xiaojunyang0805/SaxStat/software/saxstat_gui_v1/README.md

# SaxStat GUI v1.2 - Production Ready

Modern PyQt5-based GUI for the SaxStat portable potentiostat with comprehensive experiment support and analysis tools.

## Status
✅ **Production Ready (v1.2)** - Complete with 7 experiments, 4 analysis tools, gain selection, standalone executable

## Features

**Core Capabilities:**
- **7 Experiment Types:** CV, LSV, CA, SWV, DPV, NPV, POT - all production-ready
- **4 Analysis Tools:** Peak detection, baseline correction, integration, smoothing
- **Gain Selection:** 10⁴ V/A (±500 µA) / 10⁶ V/A (±100 nA) via GUI radio buttons
- **Real-time Plotting:** Dual plots with high-performance pyqtgraph
- **Professional Data Export:** CSV, JSON, Excel with formatted multi-sheet output
- **Autosave System:** Configurable automatic data saving with preferences dialog
- **Parameter Presets:** Save/load/delete presets per experiment type
- **Plot Overlays:** Compare up to 5 experiments with legend support
- **Hardware Calibration:** Offset current, TIA resistance, Vref configuration
- **Experiment History:** Automatic storage of last 50 runs for comparison
- **Standalone Executable:** `SaxStat.exe` via PyInstaller (no Python required)

**Architecture:**
- **Modular Design:** Clean separation with template method pattern
- **Plugin System:** Auto-registration decorator for experiments
- **Thread-safe Communication:** Background serial I/O with SerialManager
- **Type-safe Validation:** Parameter schemas with min/max constraints
- **Configuration Management:** JSON-based persistent settings with presets

## Supported Experiments (7 Total)

1. **Cyclic Voltammetry (CV):** Classic CV with multiple cycles
2. **Linear Sweep Voltammetry (LSV):** Single sweep voltage scan
3. **Chronoamperometry (CA):** Step potential vs time
4. **Square Wave Voltammetry (SWV):** High sensitivity differential measurement
5. **Differential Pulse Voltammetry (DPV):** Pulse waveform for trace analysis
6. **Normal Pulse Voltammetry (NPV):** Pulses from baseline potential
7. **Potentiometry (POT):** Open circuit potential monitoring

## Quick Start

### Requirements

```bash
pip install -r requirements.txt
```

Required packages:
- PyQt5 >= 5.15.0 (GUI framework)
- pyserial >= 3.5 (serial communication)
- numpy >= 1.21.0 (numerical processing)
- pandas >= 1.3.0 (data management)
- scipy >= 1.7.0 (analysis tools)
- pyqtgraph >= 0.12.0 (real-time plotting)
- openpyxl >= 3.0.0 (Excel export)

### Running the GUI

```bash
python run.py
```

Or from parent directory:
```bash
python -m saxstat_gui_v1.main
```

## Usage

1. **Select Experiment:** Choose from 7 experiment types in dropdown
2. **Connect Hardware:** Select serial port and click "Connect"
3. **Select Gain:** Choose 10⁴ V/A (±500 µA) or 10⁶ V/A (±100 nA)
4. **Load Preset (Optional):** Select saved parameter preset from dropdown
5. **Configure Parameters:** Adjust experiment parameters or use defaults
6. **Calibrate (Optional):** Settings → Calibration for hardware parameters
7. **Configure Experiment:** Click "Configure Experiment" to validate parameters
8. **Start Experiment:** Click "Start Experiment" to begin acquisition
9. **View Real-time Data:** Dual plots show voltage vs time and current vs voltage
10. **Analyze Data:** Analysis → Data Analysis Tools for peak detection, baseline correction, etc.
11. **Compare Runs:** View → Compare Experiments to overlay multiple runs
12. **Save Results:** Data auto-saves if enabled, or manually save with File → Save Data

**Menu Features:**
- **File:** Save Data (Ctrl+S), Save Plot, Exit (Ctrl+Q)
- **Analysis:** Data Analysis Tools (Ctrl+A)
- **View:** Compare Experiments (Ctrl+E)
- **Settings:** Preferences (Ctrl+P), Calibration
- **Help:** About

## Architecture

```
saxstat_gui_v1/
├── gui/                        # PyQt5 UI components
│   ├── main_window.py          # Main application window (980 lines)
│   ├── parameter_panel.py      # Dynamic parameter panel with presets (361 lines)
│   ├── analysis_panel.py       # Data analysis tools UI (267 lines)
│   ├── preferences_dialog.py   # Autosave preferences (203 lines)
│   ├── overlay_dialog.py       # Experiment comparison (165 lines)
│   └── calibration_dialog.py   # Hardware calibration (236 lines)
├── experiments/                # Experiment implementations (7 total)
│   ├── base_experiment.py      # Abstract base class (268 lines)
│   ├── experiment_registry.py  # Registry pattern (116 lines)
│   ├── cyclic_voltammetry.py   # CV implementation (277 lines)
│   ├── linear_sweep.py         # LSV implementation (280 lines)
│   ├── chronoamperometry.py    # CA implementation (285 lines)
│   ├── square_wave.py          # SWV implementation (357 lines)
│   ├── differential_pulse.py   # DPV implementation (389 lines)
│   ├── normal_pulse.py         # NPV implementation (397 lines)
│   └── potentiometry.py        # POT implementation (267 lines)
├── analysis/                   # Data analysis tools (4 total)
│   ├── peak_detection.py       # Peak finding (196 lines)
│   ├── baseline_correction.py  # Baseline subtraction (197 lines)
│   ├── integration.py          # Charge calculation (173 lines)
│   └── smoothing.py            # Filtering (186 lines)
├── communication/              # Hardware communication
│   └── serial_manager.py       # Thread-safe serial I/O (220 lines)
├── data/                       # Data management
│   └── data_manager.py         # Collection, export, history (300 lines)
├── plotting/                   # Plotting functionality
│   └── plot_manager.py         # Real-time plotting with overlays (316 lines)
├── config/                     # Configuration management
│   └── config_manager.py       # JSON settings with presets (282 lines)
└── main.py                     # Application entry point
```

## Hardware Protocol

Compatible with prototype_v03 firmware:

**Commands:**
- `START:<start_v>:<end_v>:<scan_rate>:<cycles>` - Start CV experiment
- `STOP` - Stop current experiment
- `CALIBRATE` - Run calibration routine
- `MODE_0` / `MODE_1` - Switch gain (10kΩ / 1MΩ TIA)

**Data Format:**
- ADC values: 0-32767 (ADS1115 16-bit)
- Completion message: "CV complete."

**Hardware Specs:**
- Voltage range: -1.5V to +1.5V
- DAC: AD5761 (16-bit)
- ADC: ADS1115 (16-bit)
- TIA: 10kΩ (MODE_0) or 1MΩ (MODE_1)
- Gain switches: TS5A3160 on GPIO 33/25
- Reference: 1.0V

## Configuration

Configuration stored in `~/.saxstat/config.json`:

- Serial port settings (baudrate, timeout, last port)
- UI preferences (window size, theme)
- Experiment defaults (autosave, save directory)
- Calibration values (offset current, TIA resistance, Vref)
- Gain selection (mode 0 or 1)

## Adding New Experiments

1. Create new file in `experiments/` directory
2. Inherit from `BaseExperiment`
3. Implement required methods:
   - `get_name()` - Return experiment name
   - `get_parameters()` - Define parameter schema
   - `validate_parameters()` - Validate parameter values
   - `generate_command()` - Create firmware command
   - `process_data_point()` - Parse and process data
   - `get_plot_config()` - Configure plot axes
4. Add `@register_experiment` decorator
5. Import in `experiments/__init__.py`

See `cyclic_voltammetry.py` for complete example.

## Development Status

**v1.2 - Production Ready** - ✅ Complete

**Completed Features:**
- ✅ 7 experiment types (CV, LSV, CA, SWV, DPV, NPV, POT)
- ✅ 4 data analysis tools (peaks, baseline, integration, smoothing)
- ✅ Gain selection (10⁴/10⁶ V/A) with firmware GPIO control
- ✅ Professional Excel export (3-sheet formatted)
- ✅ Autosave with preferences dialog
- ✅ Parameter presets (per-experiment save/load/delete)
- ✅ Plot overlays (compare up to 5 experiments)
- ✅ Hardware calibration dialog
- ✅ Experiment history storage (50 entries)
- ✅ Real-time dual plotting
- ✅ Thread-safe serial communication
- ✅ Configuration management with JSON
- ✅ Modern UI with Arial font styling
- ✅ Standalone executable (PyInstaller)

**Next (v1.3):**
- ⏳ Hardware validation testing (all 7 experiments)
- ⏳ Comprehensive user documentation
- ⏳ Unit test suite

## Differences from v0

- **Modern Framework:** PyQt5 vs direct tkinter
- **Modular Design:** Separated concerns vs monolithic
- **Thread-safe Communication:** Background serial thread
- **Plugin System:** Registry pattern for experiments
- **Enhanced Plotting:** pyqtgraph vs matplotlib
- **Type Safety:** Pydantic-style validation
- **Configuration:** Persistent JSON settings

## Testing

To test without hardware:
1. Run `python run.py`
2. Select "Cyclic Voltammetry" experiment
3. Configure parameters
4. Serial connection will fail (expected)
5. UI and parameter validation can be tested

To test with hardware:
1. Connect prototype_v03 board via USB
2. Select correct COM port
3. Click "Connect"
4. Configure CV parameters
5. Click "Start Experiment"
6. Monitor real-time plot
7. Save data after completion

## Known Issues

- Plot zoom/pan controls use default pyqtgraph mouse gestures
- Hardware validation needed for all 7 experiments

## References

- **v0 GUI:** `../saxstat_gui_v0/` - Original working implementation
- **DStat Analysis:** `../../docs/software/DStat_Analysis.md` - Reference architecture study
- **Architecture Doc:** `../../docs/software/SaxStat_v1_Architecture.md` - Design document
- **Firmware Protocol:** Based on prototype_v03 firmware

**Created:** 2025-10-12 | **Version:** 1.2 | **Status:** Production Ready (100% complete)
