xiaojunyang0805/SaxStat/docs/hardware/datasheets/AD5761 Pin def..xlsx

AD5761_TSSOP
Pin no. | Mnemonic | Description
1 | ALERT | Active Low Alert.
2 | CLEAR | Falling Edge Clear Input.
3 | RESET | Active Low Reset Input.
4 | VREFIN | External Reference Voltage Input.
5 | AGND | Ground Reference for Analog Circuitry.
6 | VSS | Negative Analog Supply Connection.
7 | VOUT | Analog Output Voltage of the DAC.
8 | VDD | Positive Analog Supply Connection.
9 | DNC | Do Not Connect.
10 | SDO | Serial Data Output.
11 | LDAC | Load DAC.
12 | SDI | Serial Data Input.
13 | SYNC | Active Low Synchronization Input.
14 | SCLK | Serial Clock Input.
15 | DVCC | Digital Supply.
16 | DGND | Digital Ground.
