xiaojunyang0805/SaxStat/docs/hardware/datasheets/ADS1115 Pin def..xlsx

AD1115_DYN/DGS
Pin no. | Mnemonic | Description
1 | ADDR | Digital input I2C target address select
2 | ALERT/RDY | Digital output Comparator output or conversion ready.
3 | GND | Analog Ground
4 | AIN0 | Analog input Analog input 0
5 | AIN1 | Analog input Analog input 1
6 | AIN2 | Analog input Analog input 2
7 | AIN3 | Analog input Analog input 3
8 | VDD | Analog Power supply. Connect a 0.1μF, power-supply decoupling capacitor to GND.
9 | SDA | Digital I/O Serial data input and output. Connect to VDD using a pullup resistor.
10 | SCL | Digital input Serial clock input. Connect to VDD using a pullup resistor.
