xiaojunyang0805/SaxStat/hardware/bom/BOM_SaxStat_01_PCB_SaxStat_01_2025-08-04.xlsx

No. | Quantity | Comment | Designator | Footprint | Value | Manufacturer Part | Manufacturer | Supplier Part | Supplier
1 | 2 | 10uF | C1,C4 | CAP-SMD_BD4.0-L4.3-W4.3-FD | 10uF | RVT1E100M0405 | HONOR(荣誉) | C3343 | LCSC
2 | 7 | 100nF | C2,C3,C5,C6,C8,C13,C14 | C0201 | 100nF | CL03A104KQ3NNNC | SAMSUNG(三星) | C160831 | LCSC
3 | 1 | 10nF | C7 | C0201 | 10nF | CL03A103KP3NNNC | SAMSUNG(三星) | C318549 | LCSC
4 | 1 | 470nF | C9 | C0201 | 470nF | CL03A474KQ3NNNC | SAMSUNG(三星) | C318543 | LCSC
5 | 2 | 1uF | C10,C11 | C0201 | 1uF | CL03A105MQ3CSNH | SAMSUNG(三星) | C53067 | LCSC
6 | 1 | 10uF | C12 | C0402 | 10uF | CL05A106MP5NUNC | SAMSUNG(三星) | C315248 | LCSC
7 | 2 | PM2.54-1*19 | J1,J2 | HDR-TH_19P-P2.54-V-F |  | PM2.54-1*19 | ZHOURI(洲日) | C5371990 | LCSC
8 | 1 | PZ254R-11-03P | J3 | HDR-TH_3P-P2.54-H-M-W10.4 |  | PZ254R-11-03P | XFCN(兴飞) | C492411 | LCSC
9 | 5 | 10kΩ | R1,R3,R7,R8,R11 | R0603 | 10kΩ | ARG03BTC1002 | Viking(光颉) | C309083 | LCSC
10 | 2 | 1MΩ | R2,R4 | R0603 | 1MΩ | RT0603BRD071ML | YAGEO(国巨) | C326730 | LCSC
11 | 2 | 5kΩ | R5,R6 | R0603 | 5kΩ | RT0603BRE075KL | YAGEO(国巨) | C862232 | LCSC
12 | 1 | 1kΩ | R9 | R0603 | 1kΩ | RT0603BRD071KL | YAGEO(国巨) | C110776 | LCSC
13 | 1 | 2kΩ | R10 | R0603 | 2kΩ | RT0603BRD072KL | YAGEO(国巨) | C728588 | LCSC
14 | 1 | ESP32-DevKitC | U1 | BULETM-SMD_ESP32-DEVKITC |  | ESP32-DevKitC | ESPRESSIF(乐鑫) | C571180 | LCSC
15 | 1 | LMC6484AIMX/NOPB | U2 | SOIC-14_L8.7-W3.9-P1.27-LS6.0-BL |  | LMC6484AIMX/NOPB | TI(德州仪器) | C67713 | LCSC
16 | 1 | AD5761RBRUZ | U3 | TSSOP-16_L5.0-W4.4-P0.65-LS6.4-TL |  | AD5761RBRUZ | ADI(亚德诺) | C404015 | LCSC
17 | 1 | ADS1115IDGSR | U4 | MSOP-10_L3.0-W3.0-P0.50-LS5.0-BL |  | ADS1115IDGSR | TI(德州仪器) | C37593 | LCSC
18 | 2 | TS5A3160DBVR | U5,U6 | SOT-23-6_L2.9-W1.6-P0.95-LS2.8-BR |  | TS5A3160DBVR | TI(德州仪器) | C185770 | LCSC
19 | 1 | ICL7660AIBAZA-T | U7 | SOIC-8_L5.0-W4.0-P1.27-LS6.0-BL |  | ICL7660AIBAZA-T | RENESAS(瑞萨)/IDT | C7881 | LCSC
20 | 1 | ADR4525ARZ/(TOKMAS) | U8 | SOP-8_L4.9-W3.9-P1.27-LS6.0-BL |  | ADR4525ARZ/(TOKMAS) | Tokmas(托克马斯) | C18214520 | LCSC
21 | 1 | ADR510ARTZ-REEL7 | U9 | SOT-23-3_L2.9-W1.3-P1.90-LS2.4-BR |  | ADR510ARTZ-REEL7 | ADI(亚德诺) | C77651 | LCSC
