xiaojunyang0805/SaxStat/firmware/prototype_v03/SaxStat_V03_GUI_Test_02/Note fore SaxStat_V03_GUI_Test_02.txt

Note fore SaxStat_V03_GUI_Test_02.ino
This firmware enable current mode for TIA resistor toggling between 10 kΩ and 1 MΩ.
0 for ±500 µA (10 kΩ), 1 for ±100 nA (1 MΩ)
