xiaojunyang0805/SaxStat/examples/test_data/CSPE_Fc 2mM_0.5V_SR0.02_10K.xlsx

# Start Voltage (V): -0.5
# End Voltage (V): 0.5
# Scan Rate (V/s): 0.02
# Cycles: 2
# Offset Current (µA): -20.0
Time (s) | Applied Voltage (V) | Current (µA)
2.516822338 | -0.4496635532 | -2.179297315
2.56588459 | -0.4486823082 | -2.159607468
2.61476779 | -0.4477046442 | -2.152298636
2.66442728 | -0.4467114544 | -2.142223011
2.713263273 | -0.4457347345 | -2.13071127
2.761731863 | -0.4447653627 | -2.122525797
2.810924768 | -0.4437815046 | -2.112876459
2.859820127 | -0.4428035975 | -2.105362914
2.909258604 | -0.4418148279 | -2.09522713
2.957894564 | -0.4408421087 | -2.085595351
3.00714159 | -0.4398571682 | -2.064905577
3.056595564 | -0.4388680887 | -2.045544186
3.105293989 | -0.4378941202 | -2.02614584
3.15420413 | -0.4369159174 | -2.006597624
3.203290462 | -0.4359341908 | -1.989599552
3.252113342 | -0.4349577332 | -1.968922224
3.301463842 | -0.4339707232 | -1.950776491
3.349830151 | -0.433003397 | -1.930024871
3.399396896 | -0.4320120621 | -1.911798982
3.448027372 | -0.4310394526 | -1.892321958
3.49754405 | -0.430049119 | -1.87539894
3.546360254 | -0.4290727949 | -1.858348369
3.595108747 | -0.4280978251 | -1.840057773
3.644514799 | -0.427109704 | -1.823116397
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
