xiaojunyang0805/SaxStat/examples/test_data/CSPE_Fc 2mM_SR0.02_30K.xlsx

# Start Voltage (V): -0.5
# End Voltage (V): 0.5
# Scan Rate (V/s): 0.02
# Cycles: 2
# Offset Current (µA): -5.0
Time (s) | Applied Voltage (V) | Current (µA)
2.498685122 | -0.4500262976 | -5.451934678
2.548067093 | -0.4490386581 | -5.449644763
2.596487284 | -0.4480702543 | -5.442974325
2.64585638 | -0.4470828724 | -5.436408605
2.694453716 | -0.4461109257 | -5.43144859
2.744440556 | -0.4451111889 | -5.424667953
2.793040276 | -0.4441391945 | -5.419691135
2.847105265 | -0.4430578947 | -5.412651199
2.890965462 | -0.4421806908 | -5.407646735
2.940026283 | -0.4411994743 | -5.40274709
2.988692999 | -0.44022614 | -5.391662947
3.038408995 | -0.4392318201 | -5.378517675
3.086882114 | -0.4382623577 | -5.36662597
3.136435986 | -0.4372712803 | -5.355579942
3.185020685 | -0.4362995863 | -5.343283033
3.23405385 | -0.435318923 | -5.333422622
3.282696724 | -0.4343460655 | -5.321065012
3.332381725 | -0.4333523655 | -5.312165517
3.381069183 | -0.4323786163 | -5.300254405
3.430334806 | -0.4313933039 | -5.289606984
3.478598118 | -0.4304280376 | -5.27851599
3.528241158 | -0.4294351768 | -5.269503529
3.576370955 | -0.4284725809 | -5.260051501
3.626073122 | -0.4274785376 | -5.25019268
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
