xiaojunyang0805/SaxStat/examples/test_data/CSPE_Water_SR0.02_01.xlsx

# Start Voltage (V): -0.5
# End Voltage (V): 0.5
# Scan Rate (V/s): 0.02
# Cycles: 2
# Offset Current (µA): -5.0
Time (s) | Applied Voltage (V) | Current (µA)
2.51644516 | -0.4496710968 | -5.301269744
2.565836668 | -0.4486832666 | -5.303149802
2.617484331 | -0.4476503134 | -5.294419777
2.663736343 | -0.4467252731 | -5.290471544
2.71459651 | -0.4457080698 | -5.284883655
2.76164794 | -0.4447670412 | -5.279441675
2.81097126 | -0.4437805748 | -5.274299444
2.862110853 | -0.4427577829 | -5.268454212
2.909263849 | -0.441814723 | -5.263696918
2.957384109 | -0.4408523178 | -5.25726559
3.006844282 | -0.4398631144 | -5.247874247
3.055454493 | -0.4388909101 | -5.235514062
3.104621887 | -0.4379075623 | -5.230488754
3.153506756 | -0.4369298649 | -5.220222139
3.202960253 | -0.4359407949 | -5.211111783
3.251454353 | -0.4349709129 | -5.201680927
3.305423021 | -0.4338915396 | -5.19214308
3.349427462 | -0.4330114508 | -5.183796275
3.399048567 | -0.4320190287 | -5.174363972
3.453636408 | -0.4309272718 | -5.168279596
3.497267962 | -0.4300546408 | -5.158056532
3.545614004 | -0.4290877199 | -5.151149291
3.595245361 | -0.4280950928 | -5.140106188
3.643929482 | -0.4271214104 | -5.132799815
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
