xiaojunyang0805/SaxStat/examples/test_data/250912 PCB_test_VC_01/Vitamin C_01.csv

# Start Voltage (V): 0.0
# End Voltage (V): 1.0
# Scan Rate (V/s): 0.02
# Cycles: 2
# Offset Current (µA): 0.0
Time (s) | Applied Voltage (V) | Current (µA)
2.539431571960449 | 0.05078863143920898 | 1.1777242763495004
2.588663101196289 | 0.05177326202392578 | 1.1909946545205028
2.6504087448120117 | 0.05300817489624023 | 1.2000890835987004
2.6916451454162598 | 0.053832902908325195 | 1.215269051539096
2.7514400482177734 | 0.055028800964355466 | 1.2279599104417396
2.7845046520233154 | 0.05569009304046631 | 1.2483163144908307
2.834522247314453 | 0.05669044494628906 | 1.2664235494160974
2.8864071369171143 | 0.057728142738342286 | 1.2842207777462638
2.9562127590179443 | 0.05912425518035889 | 1.297828950013435
2.985088586807251 | 0.05970177173614502 | 1.3154407037506792
3.029834032058716 | 0.060596680641174315 | 1.34986425543353
3.0869903564453125 | 0.06173980712890625 | 1.385202924382504
3.137244939804077 | 0.06274489879608154 | 1.421589767234734
3.181605815887451 | 0.06363211631774902 | 1.4598517912874134
3.2254130840301514 | 0.06450826168060303 | 1.5013113422718534
3.283330202102661 | 0.06566660404205323 | 1.5378003904028996
3.3432860374450684 | 0.06686572074890136 | 1.574801866819967
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
