xiaojunyang0805/SaxStat/examples/test_data/250912 PCB_test_VC_01/Vitamin C_02 (with case).csv

# Start Voltage (V): 0.0
# End Voltage (V): 1.0
# Scan Rate (V/s): 0.02
# Cycles: 2
# Offset Current (µA): 0.0
Time (s) | Applied Voltage (V) | Current (µA)
2.538728713989258 | 0.050774574279785156 | 3.1416898848667163
2.5872819423675537 | 0.051745638847351075 | 3.174389136117311
2.653080940246582 | 0.05306161880493164 | 3.1997580015278824
2.7013864517211914 | 0.05402772903442383 | 3.2289159183103084
2.7528512477874756 | 0.05505702495574951 | 3.2583257418048115
2.783477544784546 | 0.055669550895690915 | 3.294807685011753
2.8537559509277344 | 0.057075119018554686 | 3.3257874342242544
2.8955156803131104 | 0.057910313606262205 | 3.3588954336945087
2.9464023113250732 | 0.05892804622650147 | 3.3927829975841766
2.9835686683654785 | 0.05967137336730957 | 3.429960311361745
3.02832293510437 | 0.060566458702087406 | 3.4995465789890594
3.094177484512329 | 0.061883549690246585 | 3.56692262055858
3.1290740966796875 | 0.06258148193359375 | 3.641729177418571
3.200737237930298 | 0.06401474475860595 | 3.711864208323361
3.2243854999542236 | 0.06448770999908447 | 3.7900626223328957
3.286939859390259 | 0.06573879718780518 | 3.8618754238546367
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
