xiaojunyang0805/SaxStat/examples/test_data/250904_test/CSPE_Fc2mM_CV_01.csv

# Start Voltage (V): -0.5
# End Voltage (V): 0.5
# Scan Rate (V/s): 0.02
# Cycles: 2
# Offset Current (µA): -15.0
Time (s) | Applied Voltage (V) | Current (µA)
2.539520025253296 | -0.4492095994949341 | -3.3370740481261905
2.5942776203155518 | -0.44811444759368896 | -3.335579926522257
2.6423628330230713 | -0.4471527433395386 | -3.283802817916836
2.6896603107452393 | -0.4462067937850952 | -3.2378116672904262
2.7399959564208984 | -0.445200080871582 | -3.2178508537034745
2.7860493659973145 | -0.4442790126800537 | -3.1865604305539925
2.833024024963379 | -0.4433395195007324 | -3.1722741530883702
2.879819869995117 | -0.44240360260009765 | -3.157632929395376
2.947316884994507 | -0.4410536623001099 | -3.1404106784984123
2.974914312362671 | -0.4405017137527466 | -3.128402248810062
3.023043394088745 | -0.4395391321182251 | -3.0863526881339602
3.0869460105895996 | -0.438261079788208 | -3.0398819410049
3.132307767868042 | -0.43735384464263916 | -3.0041168461232495
3.182302474975586 | -0.4363539505004883 | -2.9801415404519034
3.22737193107605 | -0.435452561378479 | -2.94886280612484
3.2748939990997314 | -0.43450212001800537 | -2.9241279942279093
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
