xiaojunyang0805/SaxStat/examples/test_data/250904_test/CSPE_Fc2mM_CV_02.csv

# Start Voltage (V): -0.2
# End Voltage (V): 0.5
# Scan Rate (V/s): 0.02
# Cycles: 2
# Offset Current (µA): -30.0
Time (s) | Applied Voltage (V) | Current (µA)
1.6382715702056885 | -0.16723456859588626 | -0.7590957085439811
1.6699652671813965 | -0.1666006946563721 | -0.7532882610755749
1.7016353607177734 | -0.16596729278564454 | -0.7432982841538411
1.733548641204834 | -0.16532902717590334 | -0.7355093637144456
1.7647080421447754 | -0.16470583915710452 | -0.7307993903454069
1.7982103824615479 | -0.16403579235076904 | -0.7284098703038318
1.8277404308319092 | -0.16344519138336183 | -0.7279971518191743
1.8599615097045898 | -0.1628007698059082 | -0.7263675965628238
1.8756120204925537 | -0.16248775959014894 | -0.7216333996044497
1.9068794250488281 | -0.16186241149902345 | -0.7178493322083241
1.9496819972991943 | -0.16100636005401614 | -0.7113793194794873
1.9698545932769775 | -0.16060290813446046 | -0.70385512469921
2.001113176345825 | -0.1599777364730835 | -0.697498665973562
2.032372236251831 | -0.1593525552749634 | -0.6922614012798434
2.064028263092041 | -0.1587194347381592 | -0.6871234617661841
2.0953171253204346 | -0.15809365749359133 | -0.6815428266348533
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
