xiaojunyang0805/SaxStat/examples/test_data/250904_test/CSPE_Ibuprofen_8mg-ml_10mVps_01.csv

# Start Voltage (V): -1.0
# End Voltage (V): 0.0
# Scan Rate (V/s): 0.01
# Cycles: 2
# Offset Current (µA): -26.0
Time (s) | Applied Voltage (V) | Current (µA)
4.969715356826782 | -0.9503028464317321 | -4.579652183512209
5.065823316574097 | -0.9493417668342591 | -4.577704637460371
5.159721851348877 | -0.9484027814865112 | -4.570853822590575
5.270162343978882 | -0.9472983765602112 | -4.560662489239419
5.367130994796753 | -0.9463286900520325 | -4.548940656429561
5.458729028701782 | -0.9454127097129822 | -4.525141486503742
5.5543372631073 | -0.944456627368927 | -4.503942710784134
5.649352312088013 | -0.9435064768791199 | -4.488982676320813
5.761026382446289 | -0.9423897361755371 | -4.474477079967485
5.8706889152526855 | -0.9412931108474731 | -4.460088436535955
5.949681282043457 | -0.9405031871795654 | -4.430581137947662
6.04639744758606 | -0.9395360255241394 | -4.394884469198217
6.140385866165161 | -0.9385961413383483 | -4.361696865125488
6.266400098800659 | -0.9373359990119934 | -4.336316825793983
6.3453369140625 | -0.9365466308593751 | -4.302883412166192
6.456895589828491 | -0.9354310441017151 | -4.276446215317037
6.552015781402588 | -0.9344798421859741 | -4.2524602904810145
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
