xiaojunyang0805/SaxStat/examples/test_data/250904_test/CSPE_Paracetamol_2mM_50mVps_01.csv

# Start Voltage (V): 0.0
# End Voltage (V): 1.5
# Scan Rate (V/s): 0.05
# Cycles: 2
# Offset Current (µA): -28.0
Time (s) | Applied Voltage (V) | Current (µA)
1.4908196926116943 | 0.07454098463058473 | -0.023329701804772895
1.5226917266845703 | 0.07613458633422851 | -0.03425768883944613
1.5598900318145752 | 0.07799450159072875 | -0.041562412821281924
1.5735821723937988 | 0.07867910861968994 | -0.024828806092138223
1.601283311843872 | 0.0800641655921936 | -0.017489018541976264
1.6323292255401611 | 0.08161646127700806 | -0.011383261712481385
1.664724349975586 | 0.0832362174987793 | -0.010517924817417423
1.6792285442352295 | 0.08396142721176147 | 0.0013790763488259472
1.7105023860931396 | 0.08552511930465699 | 0.009925118198886196
1.744009017944336 | 0.0872004508972168 | 0.01500909353097768
1.7741649150848389 | 0.08870824575424194 | 0.022091021922687304
1.8068962097167969 | 0.09034481048583984 | 0.032493434479267336
1.8326385021209717 | 0.09163192510604858 | 0.04237366265807552
1.869882583618164 | 0.0934941291809082 | 0.04422803482231785
1.8855104446411133 | 0.09427552223205567 | 0.05211904620011154
1.9014875888824463 | 0.09507437944412231 | 0.06504436600911845
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
