xiaojunyang0805/SaxStat/examples/test_data/250904_test/CSPE_VC_2mg-ml_20mVps_01.csv

# Start Voltage (V): 0.0
# End Voltage (V): 1.0
# Scan Rate (V/s): 0.02
# Cycles: 2
# Offset Current (µA): -30.0
Time (s) | Applied Voltage (V) | Current (µA)
2.531506299972534 | 0.05063012599945069 | 0.7301451502304275
2.57877254486084 | 0.051575450897216796 | 0.7453808127489623
2.6435301303863525 | 0.05287060260772705 | 0.7531223753364777
2.707857370376587 | 0.05415714740753174 | 0.7529553949681933
2.7375521659851074 | 0.054751043319702146 | 0.7684781277628296
2.7855217456817627 | 0.055710434913635254 | 0.7857541224428708
2.833059787750244 | 0.05666119575500488 | 0.8023695087395808
2.88490891456604 | 0.057698178291320804 | 0.8174942436098718
2.9296605587005615 | 0.05859321117401123 | 0.8332024292361737
2.9766457080841064 | 0.05953291416168213 | 0.8513724056381413
3.023542642593384 | 0.06047085285186768 | 0.8829691045202068
3.0722334384918213 | 0.061444668769836425 | 0.9142808932002424
3.1257965564727783 | 0.06251593112945557 | 0.9478315753891948
3.166685104370117 | 0.06333370208740234 | 0.987320034144858
3.2145674228668213 | 0.06429134845733643 | 1.0231709883228852
3.276031494140625 | 0.0655206298828125 | 1.0563230441854792
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
