xiaojunyang0805/SaxStat/examples/test_data/250904_test/CSPE_VC_2mg-ml_50mVps_01.csv

# Start Voltage (V): 0.0
# End Voltage (V): 1.0
# Scan Rate (V/s): 0.05
# Cycles: 2
# Offset Current (µA): -30.0
Time (s) | Applied Voltage (V) | Current (µA)
1.0332374572753906 | 0.05166187286376953 | 1.5519986934197831
1.0604004859924316 | 0.05302002429962158 | 1.5590934105153949
1.078127384185791 | 0.053906369209289554 | 1.5902485994713942
1.0984694957733154 | 0.05492347478866577 | 1.614774603538745
1.1115124225616455 | 0.05557562112808227 | 1.6489482710423822
1.1256978511810303 | 0.056284892559051516 | 1.6869936854049534
1.1553573608398438 | 0.05776786804199219 | 1.716198611515889
1.1709730625152588 | 0.05854865312576294 | 1.7486556124591814
1.1865973472595215 | 0.059329867362976074 | 1.7832758949191287
1.2117390632629395 | 0.060586953163146974 | 1.8146517588111593
1.218257188796997 | 0.06091285943984985 | 1.8833968141600046
1.2495319843292236 | 0.06247659921646118 | 1.9513360242494002
1.2821779251098633 | 0.06410889625549317 | 2.010565674897009
1.3443903923034668 | 0.06721951961517333 | 2.0501101858897286
1.3624470233917236 | 0.06812235116958618 | 2.088397882880617
1.3624470233917236 | 0.06812235116958618 | 2.135028332329334
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
