xiaojunyang0805/SaxStat/examples/test_data/SaxStat_V03_pic.png

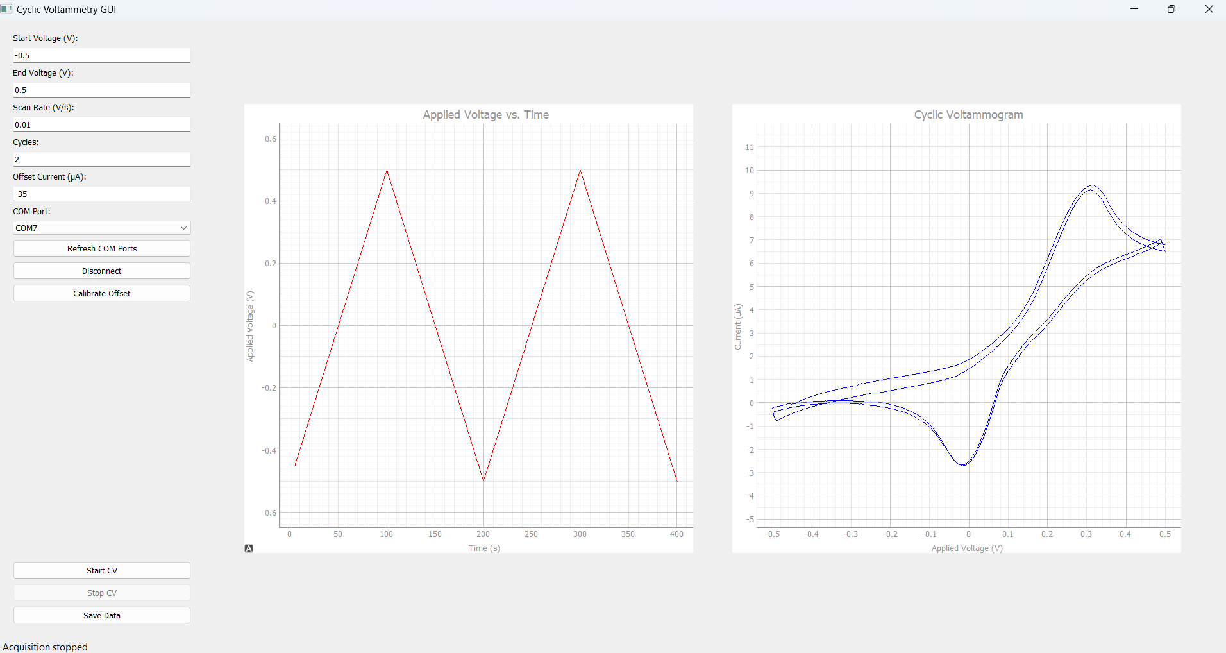
examples/test_data/SaxStat_V03_pic.png
