xiaojunyang0805/SaxStat/hardware/schematics/250804 SaxStat_v0.0.pdf

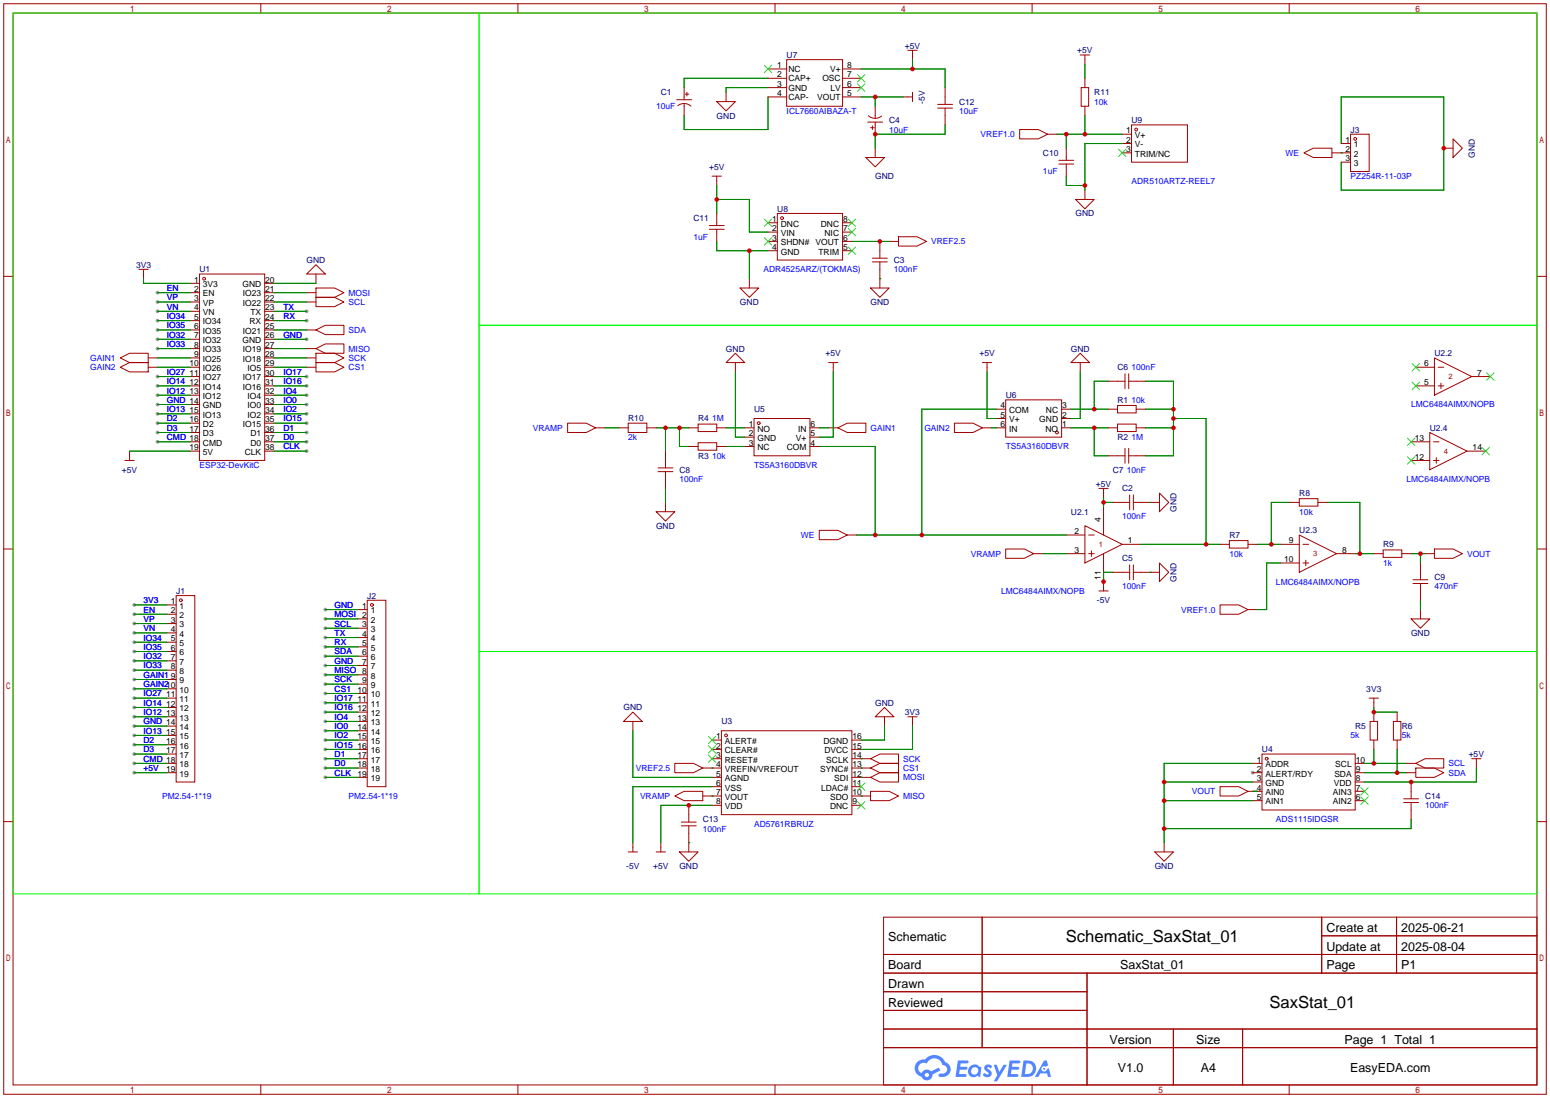
[picture p17: page 1]

SDO 10 LDAC# 11 SDI 12 SYNC# 13 SCLK 14 DVCC 15 DGND 16

Schematic | Schematic_SaxStat_01 | Create at | 2025-06-21

Update at | 2025-08-04

Board | SaxStat_01 | Page | P1
Drawn | | SaxStat_01
Reviewed

Version | Size | Page 1 Total 1
V1.0 | A4 | EasyEDA.com
