xiaojunyang0805/SaxStat/(list of files, drawings)

Other design files:
hardware/schematics/SaxStat_01.eprj
