xiaojunyang0805/SaxStat/(commit log)

2025-10-12 Initial commit: SaxStat potentiostat project
    - Organized project structure with hardware, firmware, software, docs
    - Hardware: Schematics, BOM, and 3D models included
    - Firmware: ESP32 code for prototypes v01, v02, v03
    - Software: PyQt5 GUI with cyclic voltammetry support
    - Documentation: Work plan and folder structure
    - Examples: Sample test data from electrochemical experiments
    Private content (Gerbers, business docs) excluded via .gitignore
    Project status: Prototype v03 hardware complete, GUI functional for CV
    [250623 SaxStat launch_workplan.xlsx, AD5761 Pin def..xlsx, ADS1115 Pin def..xlsx, BOM_SaxStat_01_PCB_SaxStat_01_2025-08-04.xlsx, CSPE_Fc 2mM_0.5V_SR0.02_10K.xlsx, CSPE_Fc 2mM_0.5V_SR0.02_10K_02.csv, CSPE_Fc 2mM_SR0.02_30K.xlsx, CSPE_Fc2mM_CV_01.csv]
2025-10-12 Implement Phase 5.1: Advanced Experiment Techniques (SWV, DPV, NPV, POT)
    Added 4 advanced electrochemical experiment techniques to complete Phase 5.1:
    New Experiments:
    - Square Wave Voltammetry (SWV): 357 lines
    * Enhanced sensitivity for trace analysis (sub-micromolar detection)
    * Forward/reverse pulse measurements with differential current
    * Command: SWV:<start>:<end>:<step>:<pulse>:<freq>
    - Differential Pulse Voltammetry (DPV): 389 lines
    * Excellent sensitivity (nanomolar range possible)
    * Baseline/pulse current differential measurement
    * Command: DPV:<start>:<end>:<step>:<pulse>:<period>:<width>
    - Normal Pulse Voltammetry (NPV): 397 lines
    * Excellent discrimination agains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
2025-10-12 Implement GUI UX Improvements: Dual Plots & Professional Styling
    Major UX enhancements to SaxStat GUI v1:
    Dual Plot System:
    - Added side-by-side plot layout (Applied Voltage + Main Data)
    - Left plot: Voltage vs Time shows applied waveform
    - Right plot: Main experiment data (current/voltage based on technique)
    - Helps visualize CV triangular wave, LSV ramp, SWV/DPV pulses
    - Both plots update in real-time during experiments
    Modern Styling & Typography:
    - Implemented clean blue & gray color scheme
    - Light blue backgrounds (#E3F2FD) for all sections
    - Medium blue (#64B5F6) borders and buttons
    - Near-black text (#212121) for better readability
    - Changed all fonts to Arial throughout application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
2025-10-12 Add Phase 5.2 Data Analysis Tools with UI Integration
    Implemented complete post-processing analysis suite for electrochemical data:
    Analysis Module (752 lines):
    - Peak Detection: scipy-based automatic peak finding with red/blue markers
    - Baseline Correction: polynomial/spline/linear fitting with orange overlay
    - Integration: charge calculation (Q = ∫I dt) using trapezoidal/Simpson's rule
    - Smoothing: Savitzky-Golay, moving average, exponential, Gaussian filters
    Analysis Panel UI (267 lines):
    - Method selection dropdowns and parameter controls
    - Results text display with scrollable output
    - Interactive visualization overlays on main plot
    - Auto-enable when sufficient data available (>10 p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
    [250623 SaxStat launch_workplan.xlsx, AD5761 Pin def..xlsx, ADS1115 Pin def..xlsx]
2025-10-12 GUI: Fix plot title font styling to use Arial
    Fixed issue where plot titles were not rendering in Arial font while axis labels were. PyQtGraph's setTitle() requires HTML formatting instead of CSS-style dictionaries.
    Changes:
    - plot_manager.py: Updated setTitle() to use HTML span tags with inline styles
    - plot_manager.py: Enhanced _setup_plot() with Arial font for default labels
    - plot_manager.py: Updated set_labels() to use CSS-style dictionaries for axis labels
    - main_window.py: Set labels for voltage plot after PlotManager initialization
    - DEV.md: Documented font styling investigation and solution
    All graph text (titles, axis labels, tick numbers) now displays in Arial.
    🤖 Generated w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
    [main_window.py]
2025-10-12 Docs: Reorganize WORK_PLAN v2.3 - v1.1/v1.2 scope clarification
    Reorganized version roadmap for practical development flow:
    v1.1 (Polish & Essential Features):
    - Excel export, autosave, parameter presets
    - Plot overlays for experiment comparison
    - Calibration dialog
    - Package executable (PyInstaller)
    - Focus: Production-ready tool with local, standalone features
    v1.2 (Advanced Analysis & Workflow):
    - Progress indicators, unit tests
    - Method builder basics
    - Hardware testing suite
    - Comprehensive documentation
    - Focus: Publication-ready with advanced workflow
    Rationale:
    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
2025-10-12 Docs: WORK_PLAN v2.4 - Move completed features to v1.1 for clarity
    Reorganized version roadmap to accurately reflect current progress:
    v1.1 Production Ready: 57% Complete (8/14 tasks)
    ✅ Completed:
    - 7 experiment types (CV, LSV, CA, SWV, DPV, NPV, POT)
    - 4 analysis tools (peak detection, baseline, integration, smoothing)
    🔄 Remaining (6 tasks):
    1. Autosave functionality (critical - data loss prevention)
    2. Experiment parameter presets (high productivity)
    3. Excel export implementation (openpyxl ready)
    4. Plot overlays (compare experiments)
    5. Calibration dialog (hardware accuracy)
    6. Package executable (PyInstaller)
    v1.2 Testing & Workflow (7 tasks):
    - Progress indicators, unit tests,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
2025-10-12 Feature: Implement Parameter Presets
    Add preset save/load functionality for experiment parameters:
    - ConfigManager: Add preset management methods (get, save, load, delete, rename)
    - ParameterPanel: Add preset UI controls (dropdown, save, delete buttons)
    - MainWindow: Pass config_manager to ParameterPanel
    Storage structure: config['presets'][experiment_name][preset_name] = parameters
    Each experiment type (CV, LSV, CA, etc.) has separate preset namespace.
    User workflow:
    1. Configure experiment parameters
    2. Click Save → Enter preset name → Preset saved to config.json
    3. Select preset from dropdown → Parameters auto-fill
    4. Delete presets with confirmation dialog
    🤖 Generated with [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
2025-10-12 Feature: Implement Hardware Calibration Dialog
    Add comprehensive calibration dialog for hardware parameters:
    CalibrationDialog features:
    - Offset current calibration (-100 to +100 µA)
    - TIA resistance configuration (100Ω to 1MΩ)
    - Reference voltage setting (0.1V to 5.0V)
    - Input validation with helpful error messages
    - Help text for each parameter
    - Last calibrated timestamp display
    Quick preset buttons:
    - Default (10kΩ, 1.0V)
    - High Sensitivity (100kΩ, 1.0V)
    - Low Sensitivity (1kΩ, 1.0V)
    - Reset to Defaults button
    Integration:
    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
    [calibration_dialog.py, main_window.py]
2025-10-12 Refactor: Remove offset current from CV parameters, use calibration dialog
    Remove redundant offset_current parameter from CV experiment parameters.
    Offset current is now managed through the Hardware Calibration dialog.
    - Remove 'offset_current' from CV parameter schema (was in UI panel)
    - Add load_calibration() method to CyclicVoltammetry class
    - MainWindow loads calibration from ConfigManager into experiment on creation
    - Experiment uses calibration values (offset_current, tia_resistance, vref)
    Benefits:
    - Single source of truth for hardware calibration
    - Cleaner parameter panel (removed redundant field)
    - Calibration applies to all experiments consistently
    - Professional calibra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
2025-10-12 Docs: Update WORK_PLAN v2.5 - v1.1 Production Ready Complete (93%)
    Update documentation to reflect v1.1 completion:
    v1.1 Completed Features (13/14 tasks):
    ✅ 7 experiment types (CV, LSV, CA, SWV, DPV, NPV, POT)
    ✅ 4 data analysis tools (peaks, baseline, integration, smoothing)
    ✅ Excel export with professional 3-sheet formatting
    ✅ Autosave with preferences dialog
    ✅ Experiment parameter presets (per-experiment save/load/delete)
    ✅ Plot overlays (history-based comparison with legend)
    ✅ Calibration dialog (hardware calibration with presets)
    ✅ CV refactoring (removed offset current parameter, uses calibration)
    Deferred to v1.2:
    ⏳ PyInstaller packaging (after hardware testing)
    Do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
2025-10-12 Release: Update to v1.1 - Production Ready
    Update application version from v1.0-dev to v1.1:
    - main.py: Update version to 1.1.0
    - MainWindow: Update window title to "SaxStat v1.1"
    - About dialog: Update to v1.1 with complete feature list
    - 7 experiments (CV, LSV, CA, SWV, DPV, NPV, POT)
    - 4 analysis tools (peaks, baseline, integration, smoothing)
    - New features: autosave, presets, overlays, calibration
    - README.md: Add contact email
    v1.1 Features Complete (93%):
    ✅ 7 experiment types
    ✅ 4 data analysis tools
    ✅ Excel export with formatting
    ✅ Autosave with preferences
    ✅ Parameter presets
    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
2025-10-12 Docs: Update all README files for v1.1 release
    Comprehensive README updates to reflect v1.1 production-ready status:
    Main README.md updates:
    - Status badges: prototype→production-ready, software v0.3→v1.1
    - Overview: Updated to mention 7 experiments + 4 analysis tools
    - Software section: Complete feature list with 7 experiments, 4 analysis tools
    - Added productivity features: autosave, presets, overlays, calibration
    - Updated project structure with v1.1 modules
    - Installation: Updated paths to saxstat_gui_v1
    - Quick start: Enhanced 10-step guide with all v1.1 features
    - Architecture: Detailed v1.1 components and key features
    - Development status: v1.1 93% complete with feature checklist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
2026-02-20 Feature: Add gain selection (10⁴/10⁶ V/A) to firmware and GUI
    Firmware: Add GPIO 33/25 control for TS5A3160 analog switches to
    select TIA feedback resistor (10kΩ or 1MΩ) on MODE_0/MODE_1 commands.
    GUI: Add Gain Selection radio buttons, sync on connect, persist setting.
    Docs: Update README with gain selection, fix citation and contact URL.
    [SaxStat_V03_GUI_Test_02.ino, main_window.py]
2026-02-20 Docs: Update DEV.md session summary with current status
2026-03-23 Fix: v1.2 bug fixes, body diode workaround, limit voltage to -0.2V
    - Fix serial port detection, method parameter mismatches, CV parameter
    handling, data parsing, and current formula in firmware and GUI
    - Document TS5A3160 body diode clamping issue (negative voltage error)
    - Limit all experiment voltage parameters to -0.2V minimum as workaround
    - Add PlatformIO config and app icon
    - Add .pio/ to .gitignore
    [SaxStat_V03_GUI_Test_02.ino, main_window.py]
2026-03-23 Docs: Conclude project, document voltage limitation in README
    - Mark project status as concluded (no further development)
    - Add Known Limitation section documenting body diode clamping issue
    - Update voltage range to -0.2V to +1.5V throughout
    - Remove future development plans
    - Update CLAUDE.md with final project summary
    - Include PlatformIO src/ for firmware buildability
    [main.cpp]
