xiaojunyang0805/SaxStat/(notices)

Notices in the files:
README.md:
License: MIT
